DiablosGit/FTCMS/README.md

This is an attempt to build an easy to use BMS on easy to use Hardware. Everyone contributing to this project is welcome.
