DiablosGit/FTCMS/FTCMS_V2.2/Auslegung Komponenten.rtf

Balancer Widerstand:

Maximum Cell Voltage: U_cutoff 4.2 V
Assumed %SoC Inbalance: SoC_disbalance 2.5 %
Module Capacity 5p C_5p 15 Ah
Number of Hours to Balance t_balance 8 h

Balance Current I_b
I_b = SoC_disbalance * C_5p / t_balance = 0.025 * 15 Ah /3h = 125 mA

Balance Resistance R_b = 4,2V / 125mA = 33Ohm

Powerless in heat:
P_v_balance = R_b * I_b² = 33 Ohm * (0.125A)² = 0.5 W

Temperature measurement:

Sensor: Heraeus M222 PT1000
Messtrom 0,1mA-0,3mA
Selbsterwärumung 0,4K/mW bei 0°C

Messtrom mit Spannungsteiler 1k/1k bei 5V : I=5V/2kOhm = 2,5mA -> Leistung: P=RII = 1000*0,0025 = 0W
Wiederstandsberechnungee
R = R0 * (1+ (dT * 3850 *10^-6 )
(R/R0 -1) /3850 *10^-6 = dT
