DiablosGit/FTCMS/FTCMS_V2.2/Bauteileliste FCTMS.xlsx

Kürzel | Wert | Bauteil | Menge vorhanden | Menge benötigt | Link | Stückpreis
U1 |  | ADBMS1818ASWZ | 1 | 4 | https://www.mouser.de/ProductDetail/Analog-Devices/ADBMS1818ASWZ?qs=pUKx8fyJudB64VZO6QRyWQ%3D%3D | 18.37 €
U2 |  | TSX631AILT | 2 | 4 | https://www.mouser.de/ProductDetail/STMicroelectronics/TSX631AILT?qs=761d0DE0fW%252ByRDkJAhndjg%3D%3D | 1.10 €
J1 + J2 |  | Molex 43045-2021 | 2 | 4 | https://www.mouser.de/ProductDetail/Molex/43045-2021?qs=pWIReIhcJCRhcaPh7u89sg%3D%3D | 3.80 €
J3 + J6 |  | Molex 43045-0228 | 5 | 8 | https://www.mouser.de/ProductDetail/Molex/43045-0228?qs=W1HJaynCbQzqlbKVi%252Bs9Mw%3D%3D | 0.82 €
J4 |  | Molex 43045-0400 | 1 | 4 | https://www.mouser.de/ProductDetail/Molex/43045-0400?qs=UeCeOHRHQeaIqmxE9Bxdrw%3D%3D | 1.03 €
TR1 |  | H0068ANL |  | 4 | https://www.mouser.de/ProductDetail/Pulse-Electronics/H0068ANL?qs=fi7yB2oewZmWr2X2uJO3ng%3D%3D | 5.32 €
Q1 |  | DZT5551-13 | 1 | 4 | https://www.mouser.de/ProductDetail/Diodes-Incorporated/DZT5551-13?qs=oDfC%252BbpzniwTf3QVWCXpgQ%3D%3D | 0.50 €
R1 |  | 100R
R0+ R2-R20 |  | CRM1206-FX-10R0ELF | 24 | 19 | https://www.mouser.de/ProductDetail/Bourns/CRM1206-FX-10R0ELF?qs=%2FxfeZyN5VBdEtVlwvTuF%252Bg%3D%3D | 0.11 €
R21 |  | 100R
R22 |  | 220R
R23 |  | 0R
R24 |  | - | - | - | -
R25 |  | 0R
R26-R29 |  | 51R
R30 |  | 1-3K
R31 |  | 100R
R1B1 - R18B1 |  | SG73P2BTTD330J |  |  | https://www.mouser.de/ProductDetail/KOA-Speer/SG73P2BTTD330J?qs=zqP1Ye0pHbjf43wxrOBe9Q%3D%3D | 0.13 €
RT1-RT9 |  | 10k1%
C1-C19 |  | 10u 0603 |  |  | https://www.mouser.de/ProductDetail/KYOCERA-AVX/0603YD106MAT2A | 0.84 €
C20 |  | CC1206KFX7R0BB104 | 36 | 4 | https://www.mouser.de/ProductDetail/YAGEO/CC1206KFX7R0BB104?qs=7s%252B3O6pAiyDaQFObAxTH8w%3D%3D | 0.23 €
C21+C22+C24 |  | CC1206KKX7RCBB103 | 1 | 24 | https://www.mouser.de/ProductDetail/YAGEO/CC1206KKX7RCBB103?qs=TpUtqFO9vU8xNiNH6sQ3Gg%3D%3D | 0.51 €
C23+C25 |  | C1206C105K4RAC | 1 | 8 | https://www.mouser.de/ProductDetail/KEMET/C1206C105K4RAC?qs=esDHISMOsl1e4qSv4fn%2FRQ%3D%3D | 0.14 €
C26 |  | 10n
C27+C29-C31 |  | - | - | - | -
C28 |  | 1u
C32 |  | 100n100v
D1 |  | 1206 LED | 1
