DiablosGit/FTCMS/FTCMS_V2.2/H0068ANL_3D.STEP

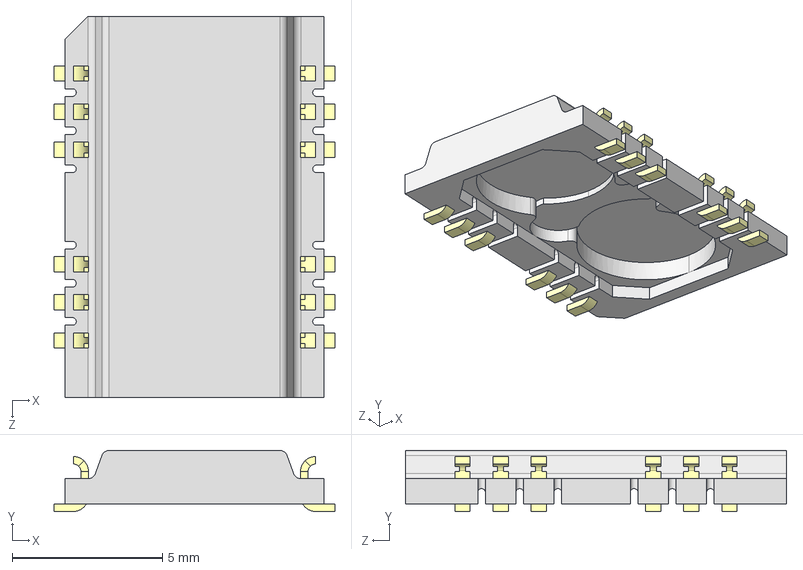
[picture p1: CAD file, 2025-05-25]
FTCMS_V2.2/H0068ANL_3D.STEP
9.36 x 2.03 x 12.7 mm
