DiablosGit/FTCMS/FTCMS_V2.2/FTCMS_V2.2.step

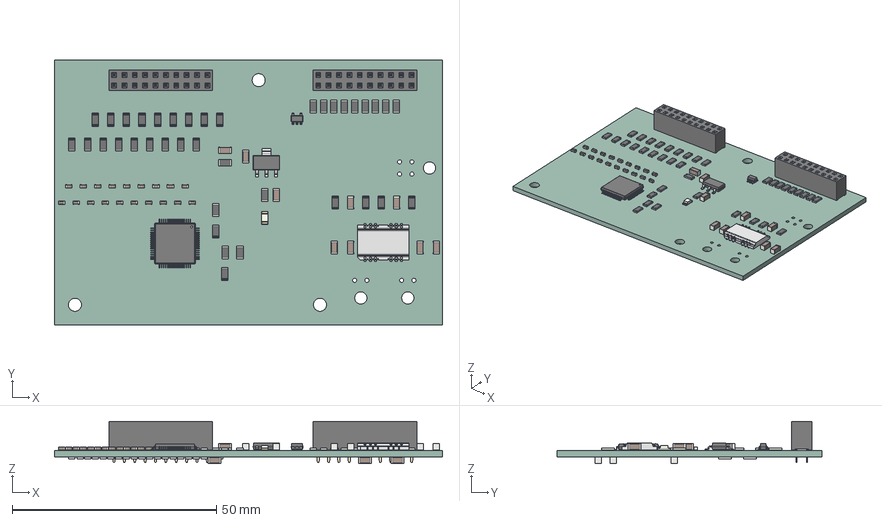
[picture p2: CAD file, 2025-05-25]
FTCMS_V2.2/FTCMS_V2.2.step
95.0 x 65.0 x 10.3 mm
PCB
