DiablosGit/FTCMS/(list of files, cad)

Other CAD files:
FTCMS_V2.2/FTCMS_V2.2/FTCMS_V2.2/FTCMS_V2.2.ipt
