DiablosGit/FTCMS/(threads)

Thread 1 (2024-12-19):

Some questions about creating a BMS with the adbms1818.

maybethomas, 2024-12-19:
Hi,

Just came across your repository while looking for resources on how to use the adbms1818 (there aren't many!). I'm trying to create a BMS as a university project, but the whole wiring up ICs and creating PCBs is new to me. I have made an initial schematic on kicad (with some help from your files.) but still unsure about a few things. Would you mind it if i asked you a few questions? It seems like you've got it figured out. I'm not sure if i should be asking these types of question on here, so don't worry if not.

Thanks!
