DiablosGit/FTCMS/FTCMS_V2.2/FTCMS_V2.2.kicad_pcb

## KiCad design FTCMS_V2.2/FTCMS_V2.2.kicad_pcb (2025-05-25)

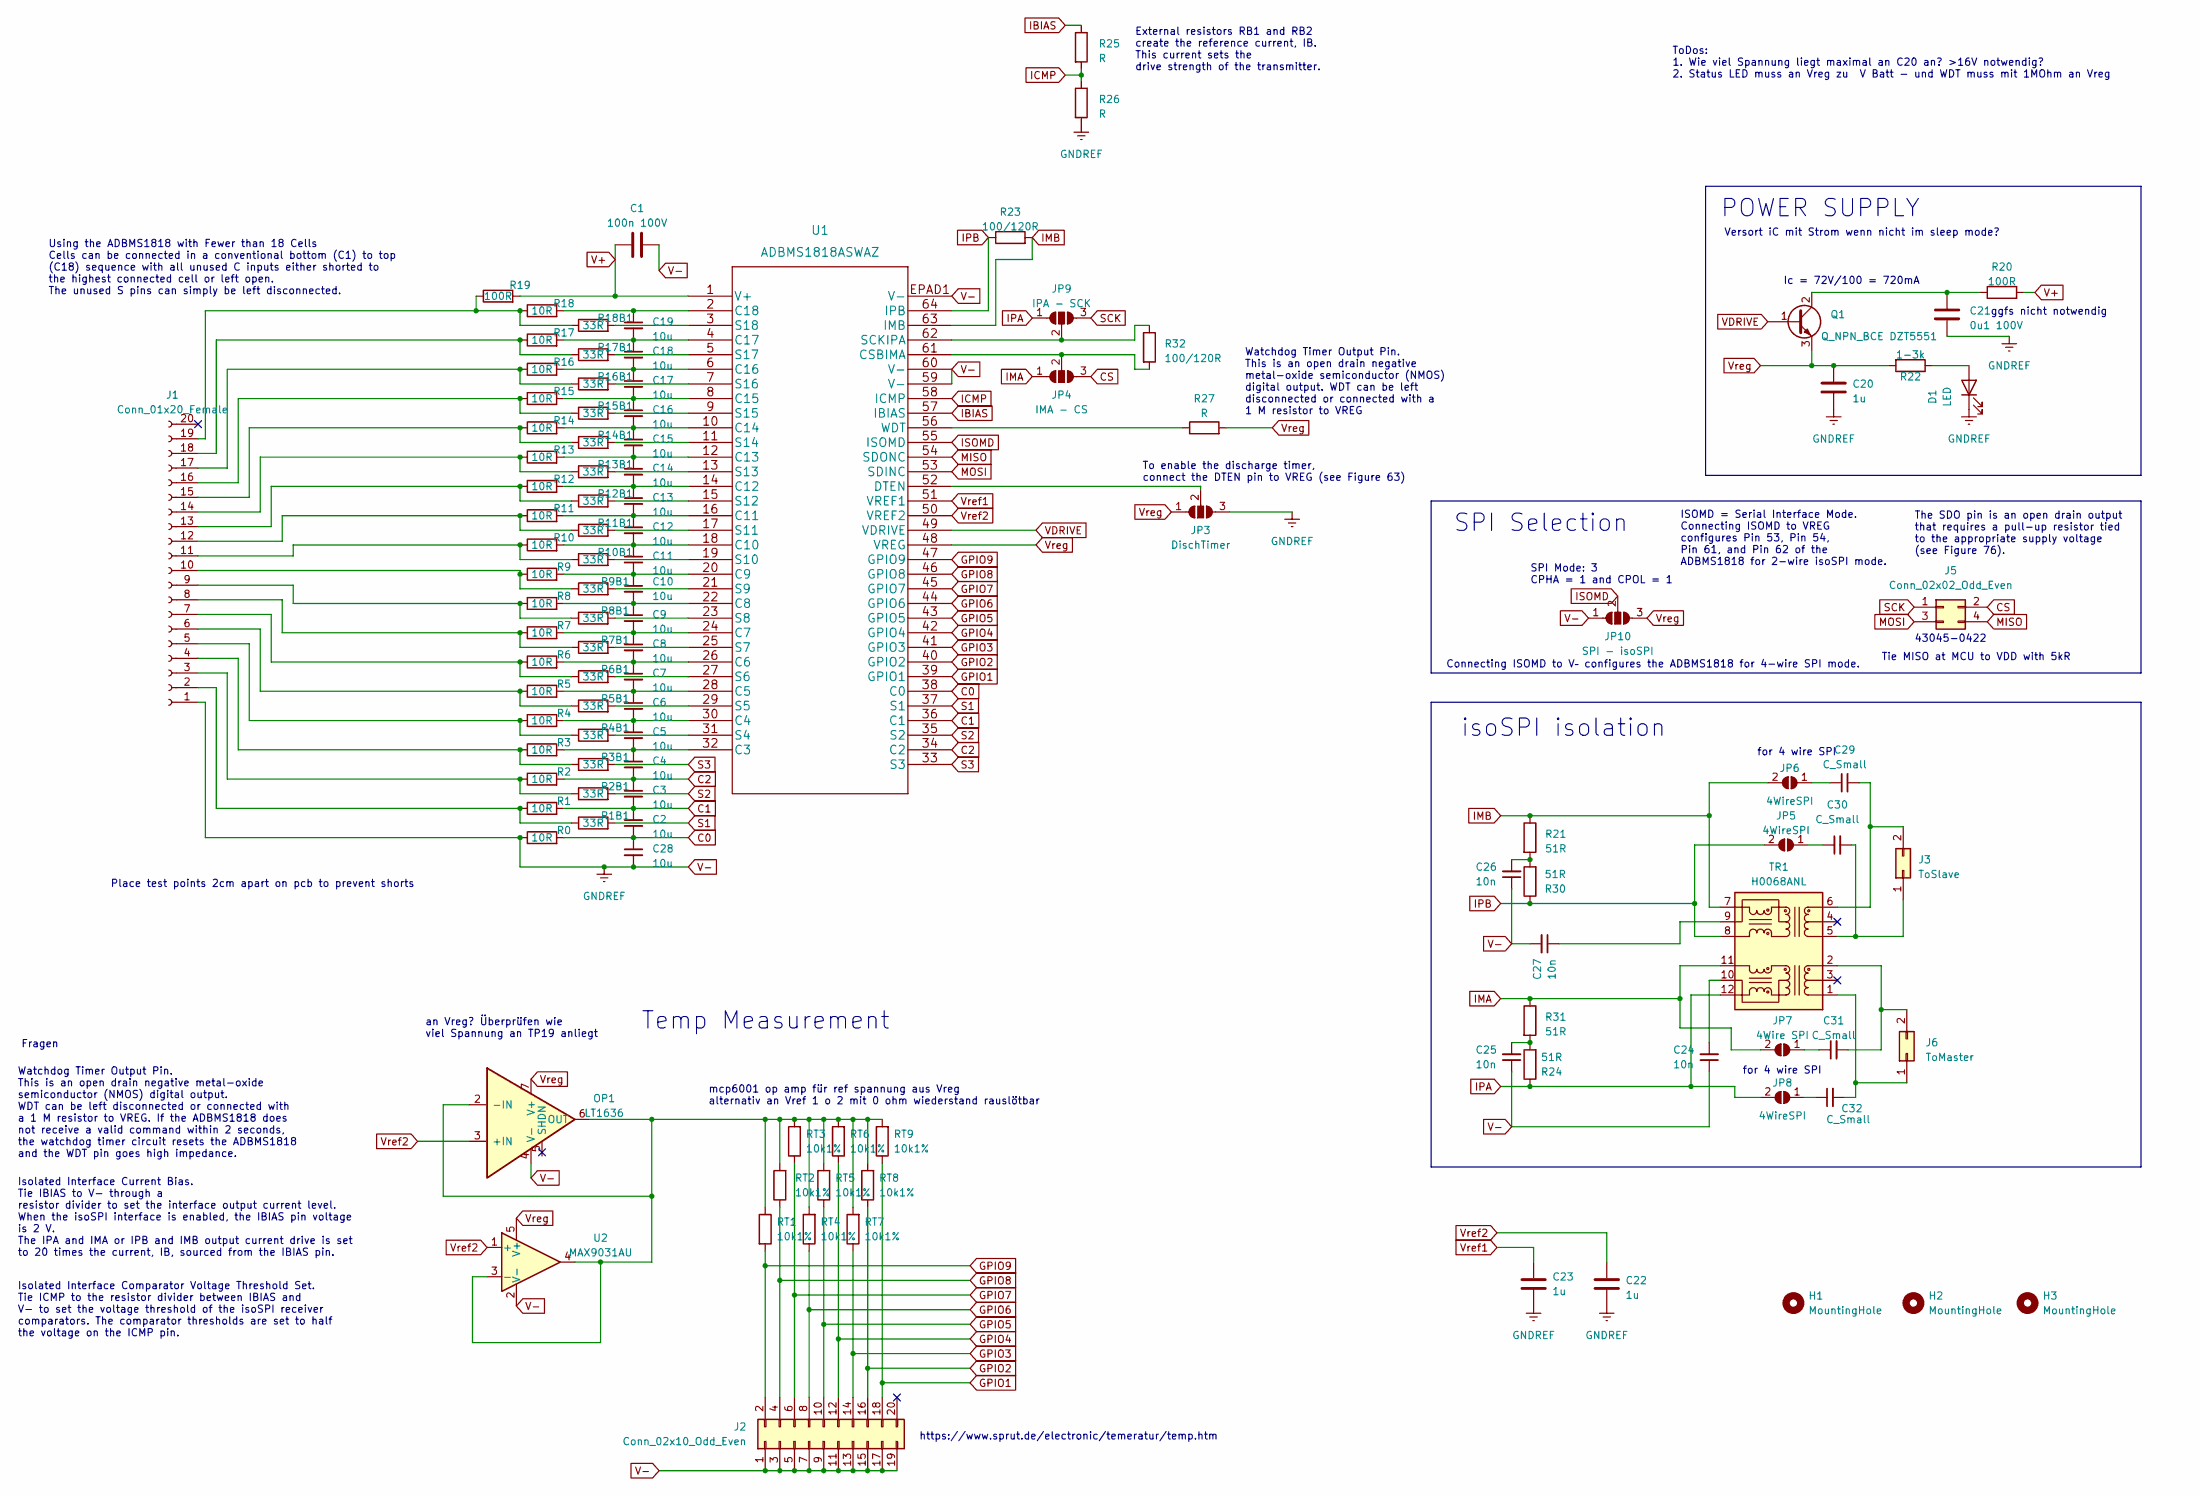
[picture p3: schematic FTCMS_V2.2.kicad_sch]

Parts:
C1: 100n 100V; C_1206_3216Metric_Pad1.33x1.80mm_HandSolder
C2, C3, C4, C5, C6, C7, C8, C9, C10, C11, C12, C13, C14, C15, C16, C17, C18, C19, C28: 10u; C_0603_1608Metric_Pad1.08x0.95mm_HandSolder
C20, C22, C23: 1u; C_1206_3216Metric_Pad1.33x1.80mm_HandSolder
C21: 0u1 100V; C_1206_3216Metric_Pad1.33x1.80mm_HandSolder
C24, C25, C26, C27: 10n; C_1206_3216Metric_Pad1.33x1.80mm_HandSolder
C29, C30, C31, C32: C_Small; C_1206_3216Metric_Pad1.33x1.80mm_HandSolder
D1: LED; LED_1206_3216Metric_Pad1.42x1.75mm_HandSolder
H1, H2, H3: MountingHole; MountingHole_3.2mm_M3_DIN965
J1: Conn_01x20_Female; PinSocket_2x10_P2.54mm_Vertical
J2: Conn_02x10_Odd_Even; PinSocket_2x10_P2.54mm_Vertical
J3: ToSlave; Molex_Micro-Fit_3.0_43650-0200_1x02_P3.00mm_Horizontal
J5: Conn_02x02_Odd_Even; Molex_Micro-Fit_3.0_43045-0400_2x02_P3.00mm_Horizontal
J6: ToMaster; Molex_Micro-Fit_3.0_43650-0200_1x02_P3.00mm_Horizontal
JP3: DischTimer; SolderJumper-3_P2.0mm_Open_TrianglePad1.0x1.5mm
JP4: IMA - CS; SolderJumper-3_P2.0mm_Open_TrianglePad1.0x1.5mm
JP5, JP6, JP8: 4WireSPI; SolderJumper-2_P1.3mm_Open_TrianglePad1.0x1.5mm
JP7: 4Wire SPI; SolderJumper-2_P1.3mm_Open_TrianglePad1.0x1.5mm
JP9: IPA - SCK; SolderJumper-3_P2.0mm_Open_TrianglePad1.0x1.5mm
JP10: SPI - isoSPI; SolderJumper-3_P2.0mm_Open_TrianglePad1.0x1.5mm
OP1: LT1636; DIP-8_W7.62mm_Socket_LongPads
Q1: Q_NPN_BCE DZT5551; SOT-223-3_TabPin2
R0, R1, R2, R3, R4, R5, R6, R7, R8, R9, R10, R11, R12, R13, R14, R15, R16, R17, R18: 10R; R_1206_3216Metric_Pad1.30x1.75mm_HandSolder
R1B1, R2B1, R3B1, R4B1, R5B1, R6B1, R7B1, R8B1, R9B1, R10B1, R11B1, R12B1, R13B1, R14B1, R15B1, R16B1, R17B1, R18B1: 33R; R_1206_3216Metric_Pad1.30x1.75mm_HandSolder
R19, R20: 100R; R_1206_3216Metric_Pad1.30x1.75mm_HandSolder
R21, R24, R30, R31: 51R; R_1206_3216Metric_Pad1.30x1.75mm_HandSolder
R22: 1-3k; R_1206_3216Metric_Pad1.30x1.75mm_HandSolder
R23, R32: 100/120R; R_1206_3216Metric_Pad1.30x1.75mm_HandSolder
R25, R26, R27: R; R_1206_3216Metric_Pad1.30x1.75mm_HandSolder
RT1, RT2, RT3, RT4, RT5, RT6, RT7, RT8, RT9: 10k1%; R_1206_3216Metric_Pad1.30x1.75mm_HandSolder
TR1: H0068ANL
U1: ADBMS1818ASWAZ; LQFP-64-1EP_10x10mm_P0.5mm_EP5x5mm_ThermalVias
U2: MAX9031AU; SOT-23-5

Connections:
C0: C2.2, C28.1, R0.2, U1.38 (C0)
C1: C2.1, C3.2, R1.2, U1.36 (C1)
C2: C3.1, C4.2, R2.2, U1.34 (C2)
CS: J5.2, JP4.3 (B)
GPIO1: J2.18, RT9.1, U1.39 (GPIO1)
GPIO2: J2.16, RT8.1, U1.40 (GPIO2)
GPIO3: J2.14, RT7.1, U1.41 (GPIO3)
GPIO4: J2.12, RT6.1, U1.42 (GPIO4)
GPIO5: J2.10, RT5.1, U1.43 (GPIO5)
GPIO6: J2.8, RT4.1, U1.44 (GPIO6)
GPIO7: J2.6, RT3.1, U1.45 (GPIO7)
GPIO8: J2.4, RT2.1, U1.46 (GPIO8)
GPIO9: J2.2, RT1.2, U1.47 (GPIO9)
IBIAS: R25.1, U1.57 (IBIAS)
ICMP: R25.2, R26.1, U1.58 (ICMP)
IMA: JP4.1 (A), JP7.2 (B), R31.1, TR1.11 (RX-)
IMB: JP6.2 (B), R21.1, R23.2, TR1.7 (TX-), U1.63 (IMB)
IPA: JP8.2 (B), JP9.1 (A), R24.1, TR1.12 (RX+)
IPB: JP5.2 (B), R23.1, R30.1, TR1.8 (TX+), U1.64 (IPB)
ISOMD: JP10.2 (C), U1.55 (ISOMD)
MISO: J5.4, U1.54 (SDONC)
MOSI: J5.3, U1.53 (SDINC)
unnamed: C25.2, R24.2, R31.2
unnamed: C26.2, R21.2, R30.2
unnamed: D1.2 (A), R22.1
unnamed: J1.2, R1.1, R1B1.1
unnamed: J1.3, R2.1, R2B1.1
unnamed: J1.4, R3.1, R3B1.1
unnamed: J1.5, R4.1, R4B1.1
unnamed: J1.6, R5.1, R5B1.1
unnamed: J1.7, R6.1, R6B1.1
unnamed: J1.8, R7.1, R7B1.1
unnamed: J1.9, R8.1, R8B1.1
unnamed: J1.10, R9.1, R9B1.1
unnamed: J1.11, R10.1, R10B1.1
unnamed: J1.12, R11.1, R11B1.1
unnamed: J1.13, R12.1, R12B1.1
unnamed: J1.14, R13.1, R13B1.1
unnamed: J1.15, R14.1, R14B1.1
unnamed: J1.16, R15.1, R15B1.1
unnamed: J1.17, R16.1, R16B1.1
unnamed: J1.18, R17.1, R17B1.1
unnamed: J1.19, R18.1, R18B1.1, R19.1
unnamed: C30.2, J3.1, TR1.5 (TD+)
unnamed: C29.2, J3.2, TR1.6 (TD-)
unnamed: C32.2, J6.1, TR1.1 (RD+)
unnamed: C31.2, J6.2, TR1.2 (RD-)
unnamed: JP3.2 (C), U1.52 (DTEN)
unnamed: JP4.2 (C), R32.2, U1.61 (CSBIMA)
unnamed: C30.1, JP5.1 (A)
unnamed: C29.1, JP6.1 (A)
unnamed: C31.1, JP7.1 (A)
unnamed: C32.1, JP8.1 (A)
unnamed: JP9.2 (C), R32.1, U1.62 (SCKIPA)
unnamed: OP1.2 (-IN), OP1.6 (OUT), RT1.1, RT2.2, RT3.2, RT4.2, RT5.2, RT6.2, RT7.2, RT8.2, RT9.2, U2.3 (-), U2.4
unnamed: C21.1, Q1.2 (C), R20.1
unnamed: C24.2, TR1.10 (RXCT)
unnamed: C27.1, TR1.9 (TXCT)
unnamed: C4.1, C5.2, R3.2, U1.32 (C3)
unnamed: C5.1, C6.2, R4.2, U1.30 (C4)
unnamed: C6.1, C7.2, R5.2, U1.28 (C5)
unnamed: C7.1, C8.2, R6.2, U1.26 (C6)
unnamed: C8.1, C9.2, R7.2, U1.24 (C7)
unnamed: C9.1, C10.2, R8.2, U1.22 (C8)
unnamed: C10.1, C11.2, R9.2, U1.20 (C9)
unnamed: C11.1, C12.2, R10.2, U1.18 (C10)
unnamed: C12.1, C13.2, R11.2, U1.16 (C11)
unnamed: C13.1, C14.2, R12.2, U1.14 (C12)
unnamed: C14.1, C15.2, R13.2, U1.12 (C13)
unnamed: C15.1, C16.2, R14.2, U1.10 (C14)
unnamed: C16.1, C17.2, R15.2, U1.8 (C15)
unnamed: C17.1, C18.2, R16.2, U1.6 (C16)
unnamed: C18.1, C19.2, R17.2, U1.4 (C17)
unnamed: C19.1, R18.2, U1.2 (C18)
unnamed: R4B1.2, U1.31 (S4)
unnamed: R5B1.2, U1.29 (S5)
unnamed: R6B1.2, U1.27 (S6)
unnamed: R7B1.2, U1.25 (S7)
unnamed: R8B1.2, U1.23 (S8)
unnamed: R9B1.2, U1.21 (S9)
unnamed: R10B1.2, U1.19 (S10)
unnamed: R11B1.2, U1.17 (S11)
unnamed: R12B1.2, U1.15 (S12)
unnamed: R13B1.2, U1.13 (S13)
unnamed: R14B1.2, U1.11 (S14)
unnamed: R15B1.2, U1.9 (S15)
unnamed: R16B1.2, U1.7 (S16)
unnamed: R17B1.2, U1.5 (S17)
unnamed: R18B1.2, U1.3 (S18)
unnamed: R27.1, U1.56 (WDT)
S1: R1B1.2, U1.37 (S1)
S2: R2B1.2, U1.35 (S2)
S3: R3B1.2, U1.33 (S3)
SCK: J5.1, JP9.3 (B)
V+: C1.1, R19.2, R20.2, U1.1 (V+)
V-: C1.2, C20.2, C21.2, C22.2, C23.2, C24.1, C25.1, C26.1, C27.2, C28.2, D1.1 (K), J1.1, J2.1, J2.3, J2.5, J2.7, J2.9, J2.11, J2.13, J2.15, J2.17, J2.19, JP3.3 (B), JP10.1 (A), R0.1, R26.2, U1.59 (V-), U1.60 (V-), U1.EPAD1 (V-), U2.2 (V-)
VDRIVE: Q1.1 (B), U1.49 (VDRIVE)
Vref1: C23.1, U1.51 (VREF1)
Vref2: C22.1, U1.50 (VREF2), U2.1 (+)
Vreg: C20.1, JP3.1 (A), JP10.3 (B), Q1.3 (E), R22.2, R27.2, U1.48 (VREG), U2.5 (V+)

Notes on the sheet:
ToDos: 1. Wie viel Spannung liegt maximal an C20 an? >16V notwendig? 2. Status LED muss an Vreg zu V Batt - und WDT muss mit 1MOhm an Vreg
https://www.sprut.de/electronic/temeratur/temp.htm
Watchdog Timer Output Pin. This is an open drain negative metal-oxide semiconductor (NMOS) digital output. WDT can be left disconnected or connected with a 1 M resistor to VREG. If the ADBMS1818 does not receive a valid command within 2 seconds, the watchdog timer circuit resets the ADBMS1818 and t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
Watchdog Timer Output Pin. This is an open drain negative metal-oxide semiconductor (NMOS) digital output. WDT can be left disconnected or connected with a 1 M resistor to VREG
SPI Selection
Place test points 2cm apart on pcb to prevent shorts
POWER SUPPLY
To enable the discharge timer, connect the DTEN pin to VREG (see Figure 63)
Temp Measurement
SPI Mode: 3 CPHA = 1 and CPOL = 1
Isolated Interface Current Bias. Tie IBIAS to V- through a resistor divider to set the interface output current level. When the isoSPI interface is enabled, the IBIAS pin voltage is 2 V. The IPA and IMA or IPB and IMB output current drive is set to 20 times the current, IB, sourced from the IBIAS p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
Ic = 72V/100 = 720mA
for 4 wire SPI
isoSPI isolation
an Vreg? Überprüfen wie viel Spannung an TP19 anliegt
43045-0422
mcp6001 op amp für ref spannung aus Vreg alternativ an Vref 1 o 2 mit 0 ohm wiederstand rauslötbar
External resistors RB1 and RB2 create the reference current, IB. This current sets the drive strength of the transmitter.
Using the ADBMS1818 with Fewer than 18 Cells Cells can be connected in a conventional bottom (C1) to top (C18) sequence with all unused C inputs either shorted to the highest connected cell or left open. The unused S pins can simply be left disconnected.
Tie MISO at MCU to VDD with 5kR
ggfs nicht notwendig
Versort iC mit Strom wenn nicht im sleep mode?
Isolated Interface Comparator Voltage Threshold Set. Tie ICMP to the resistor divider between IBIAS and V- to set the voltage threshold of the isoSPI receiver comparators. The comparator thresholds are set to half the voltage on the ICMP pin.
ISOMD = Serial Interface Mode. Connecting ISOMD to VREG configures Pin 53, Pin 54, Pin 61, and Pin 62 of the ADBMS1818 for 2-wire isoSPI mode.
Connecting ISOMD to V– configures the ADBMS1818 for 4-wire SPI mode.
Fragen
The SDO pin is an open drain output that requires a pull-up resistor tied to the appropriate supply voltage (see Figure 76).

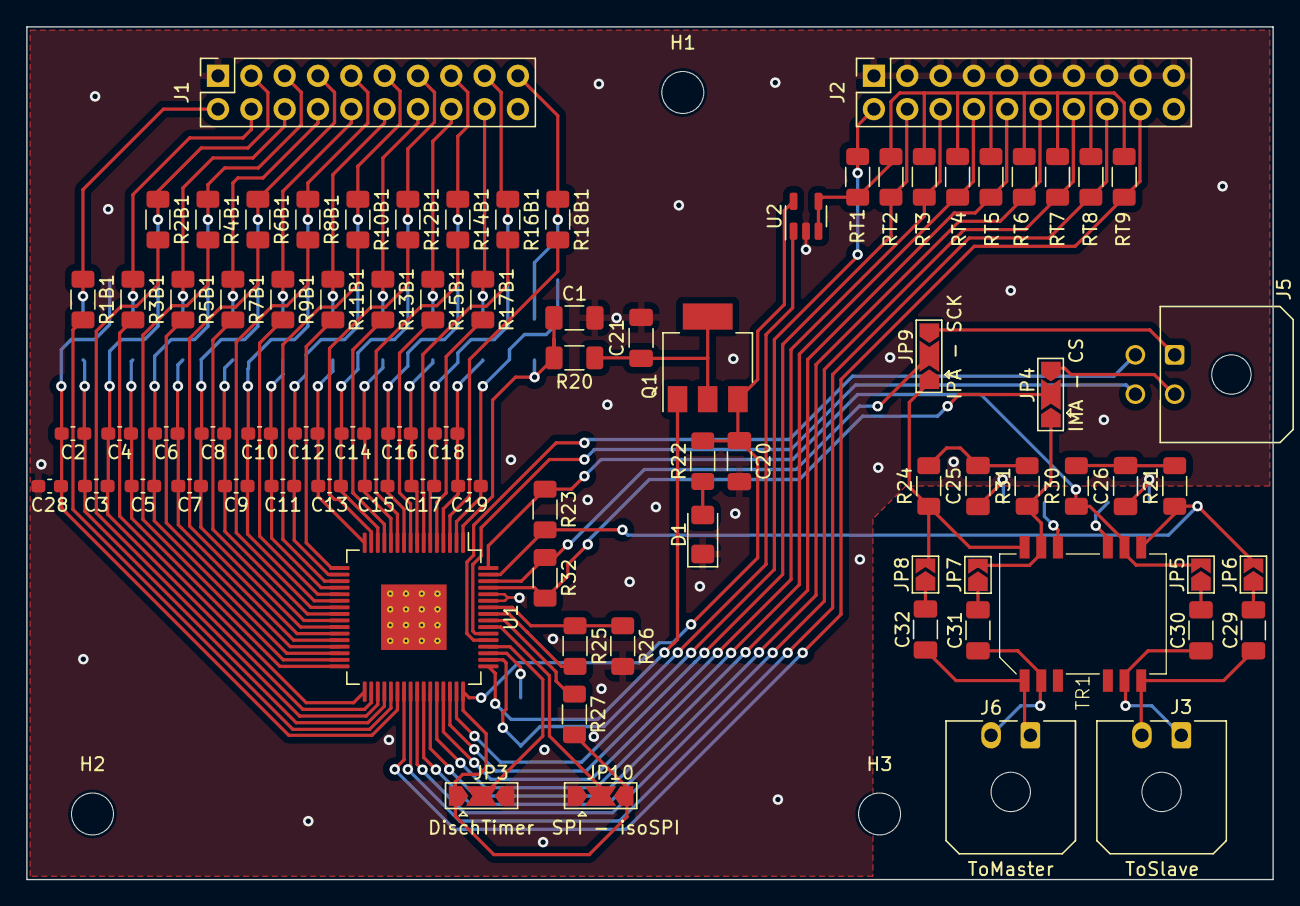
[picture p4: board FTCMS_V2.2.kicad_pcb from above]

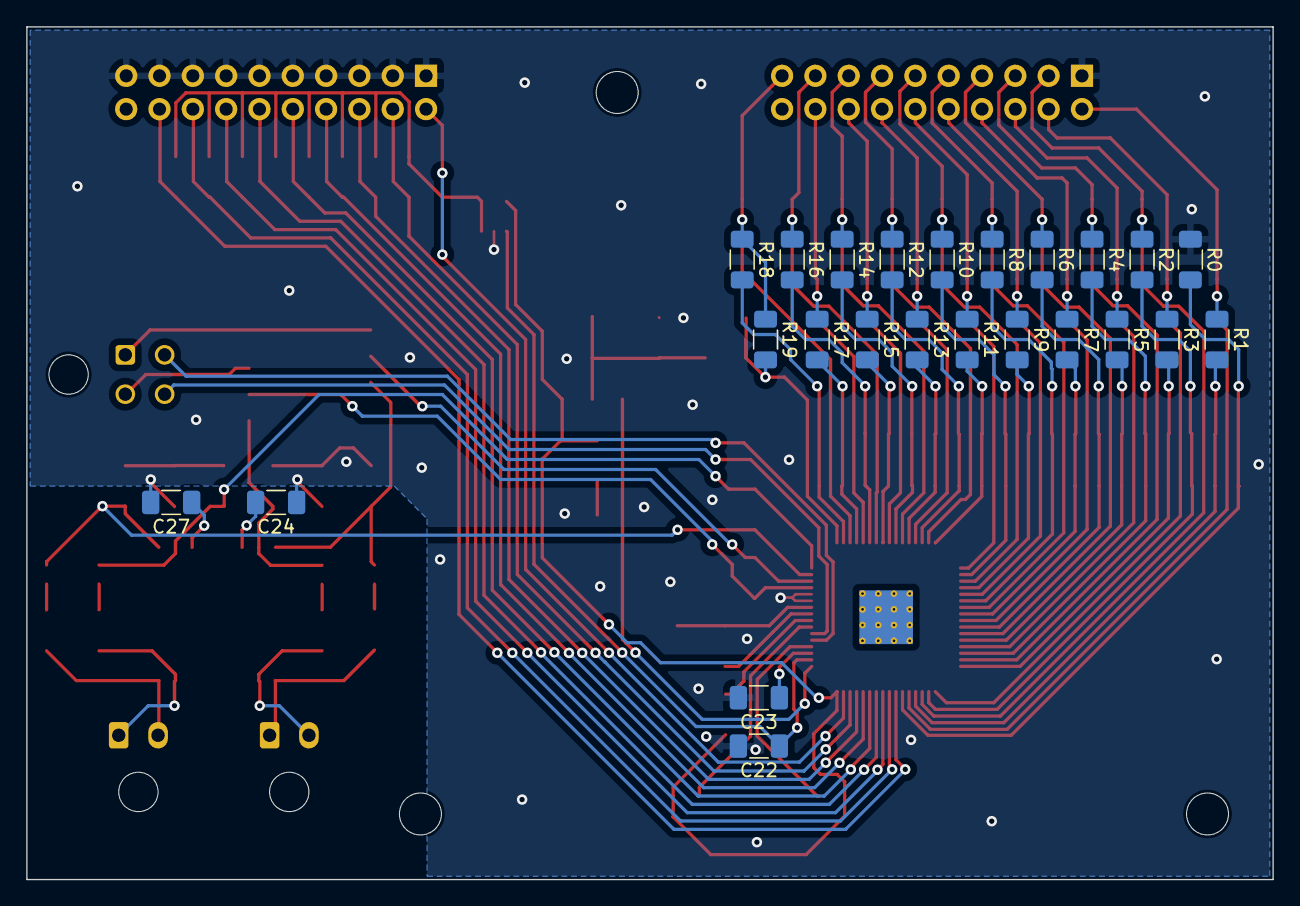
[picture p5: board FTCMS_V2.2.kicad_pcb from below]

Board: 2 copper layers, 95.0 x 65.0 mm, 111 parts (24 on the bottom side), 100 nets.
