DiablosGit/FTCMS/SW/FTCMS/include/bms_hardware.h

/*!
  ADBMS181x hardware library
@verbatim
  This library contains all of the hardware dependant functions used by the bms
  code
@endverbatim

Copyright 2018(c) Analog Devices, Inc.

All rights reserved.

Redistribution and use in source and binary forms, with or without
modification, are permitted provided that the following conditions are met:
 - Redistributions of source code must retain the above copyright
   notice, this list of conditions and the following disclaimer.
 - Redistributions in binary form must reproduce the above copyright
   notice, this list of conditions and the following disclaimer in
   the documentation and/or other materials provided with the
   distribution.
 - Neither the name of Analog Devices, Inc. nor the names of its
   contributors may be used to endorse or promote products derived
   from this software without specific prior written permission.
 - The use of this software may or may not infringe the patent rights
   of one or more patent holders.  This license does not release you
   from the requirement that you obtain separate licenses from these
   patent holders to use this software.
 - Use of the software either in source or binary form, must be run
   on or directly connected to an Analog Devices Inc. component.

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
Copyright 2017 Linear Technology Corp. (LTC)
*/
#ifndef BMSHARDWARE_H
#define BMSHARDWARE_H


// included in Arduino?!
#include <stdint.h>


void cs_low(uint8_t pin);//name conflicts with linduino

void cs_high(uint8_t pin);

void delay_u(uint16_t micro);

void delay_m(uint16_t milli);

void set_spi_freq();


/*
Writes an array of bytes out of the SPI port
*/
void spi_write_array(uint8_t len, // Option: Number of bytes to be written on the SPI port
                     uint8_t data[] //Array of bytes to be written on the SPI port
                    );
/*
 Writes and read a set number of bytes using the SPI port.

*/

void spi_write_read(uint8_t tx_Data[],//array of data to be written on SPI port
                    uint8_t tx_len, //length of the tx data arry
                    uint8_t *rx_data,//Input: array that will store the data read by the SPI port
                    uint8_t rx_len //Option: number of bytes to be read from the SPI port
                   );

uint8_t spi_read_byte(uint8_t tx_dat);//name conflicts with linduino also needs to take a byte as a parameter
#endif
