DiablosGit/FTCMS/FTCMS_V2.2/Datasheets/LTSketchbook/Part Number/6000/6952/DC2609A/DC2609A.ino

/*!
DC2609A
LTC6952: Ultralow Jitter, 4.5GHz PLL with 11 Outputs and JESD204B Support

@verbatim

  Setup:
    Set the terminal baud rate to 115200 and select the newline terminator.
    Refer to Demo Manual DC2609A.
    One Power Supply is needed for this demo board: 3.3V supply.


Command Description:
    1-  Load Default Settings from a Look-up Table- Loads the SPI map from one of several options in a
        look-up table.  The look-up table allows the user to select different frequencies and synchronization
        option.

    2-  READ/WRITE to Registers Addresses- Selecting this option will cause all the registers to
        be read, stored to variables, and displayed.  The user will then have the option
        to write to one register address at a time.

    3-  READ/WRITE to Registers Fields- Selecting this option will allow the user
        to read or write to one register field name at a time.

    4-  This function stores the current SPI settings in the demo boards EEPROM

    5-  This function loads SPI settings from the demo boards EEPROM to the device

    6 - SPI Frequency:  Allows user to control Linduino's SPI frequency.  By default this is set to 8MHz
        when connecting Linduino directly to the DC2609.  If Linduino is connected to the DC2430 the default
        SPI rate is 4MHz

    7 - If using a DC2430 (Linduino Expander), this allows the user to select 1 of 8 sites to talk to.

USER INPUT DATA FORMAT:
 decimal : 1024
 hex     : 0x400
 octal   : 02000  (leading 0 "zero")
 binary  : B10000000000
 float   : 1024.0

@endverbatim

http://www.linear.com/product/LTC6952

http://www.linear.com/product/LTC6952#demoboards


Copyright 2018(c) Analog Devices, Inc.

All rights reserved.

Redistribution and use in source and binary forms, with or without
modification, are permitted provided that the following conditions are met:
 - Redistributions of source code must retain the above copyright
   notice, this list of conditions and the following disclaimer.
 - Redistributions in binary form must reproduce the above copyright
   notice, this list of conditions and the following disclaimer in
   the documentation and/or other materials provided with the
   distribution.
 - Neither the name of Analog Devices, Inc. nor the names of its
   contributors may be used to endorse or promote products derived
   from this software without specific prior written permission.
 - The use of this software may or may not infringe the patent rights
   of one or more patent holders.  This license does not release you
   from the requirement that you obtain separate licenses from these
   patent holders to use this software.
 - Use of the software either in source or binary form, must be run
   on or directly connected to an Analog Devices Inc. component.

THIS SOFTWARE IS PROVIDED BY ANALOG DEVICES "AS IS" AND ANY EXPRESS OR
IMPLIED WARRANTIES, INCLUDING, BUT NOT LIMITED TO, NON-INFRINGEMENT,
MERCHANTABILITY AND FITNESS FOR A PARTICULAR PURPOSE ARE DISCLAIMED.
IN NO EVENT SHALL ANALOG DEVICES BE LIABLE FOR ANY DIRECT, INDIRECT,
INCIDENTAL, SPECIAL, EXEMPLARY, OR CONSEQUENTIAL DAMAGES (INCLUDING, BUT NOT
LIMITED TO, INTELLECTUAL PROPERTY RIGHTS, PROCUREMENT OF SUBSTITUTE GOODS OR
SERVICES; LOSS OF USE, DATA, OR PROFITS; OR BUSINESS INTERRUPTION) HOWEVER
CAUSED AND ON ANY THEORY OF LIABILITY, WHETHER IN CONTRACT, STRICT LIABILITY,
OR TORT (INCLUDING NEGLIGENCE OR OTHERWISE) ARISING IN ANY WAY OUT OF THE USE
OF THIS SOFTWARE, EVEN IF ADVISED OF THE POSSIBILITY OF SUCH DAMAGE.
*/

/*! @file
    @ingroup LTC6952
*/

#include <Arduino.h>
#include <stdint.h>
#include "Linduino.h"
#include "LT_SPI.h"
#include "UserInterface.h"
#include "LT_I2C.h"
#include "QuikEval_EEPROM.h"
#include "LTC6952.h"
#include <SPI.h>
#include <Wire.h>

// Function Declaration
void print_title();             // Print the title block
void print_prompt();            // Print the main menu
void menu_1_load_default_settings();  // Sub-menus
void menu_2_RW_to_reg_addresss();
void menu_3_RW_to_reg_field();
void menu_4_store_settings();
void menu_5_restore_settings();
void menu_6_SPI_speed();
void menu_7_DC2430_site_select();
//void DUTsync();

// Global Variables
static int8_t demo_board_connected = 0;    //!< Demo Board Name stored in QuikEval EEPROM
static int8_t DC2609_board_connected = 0;  //!< Demo Board Name stored in QuikEval EEPROM
uint8_t First_Run=0;                       //!< if first time through loop = 0, otherwise=1
boolean Using_DC2430= false;               //!< Indicator if DC2430 (Linduino Expander) is connected

// Analog Pins used on DC2430 (Linduino Expander)
int dc2430_site_A0_APin =0;                //!< DC2430 resistor tree, if it reads 3.3V then DC2430 connected
int dc2430_site_A1_APin =1;                //!< DC2430 resistor tree, if it reads 1.66V then DC2430 connected
int dc2430_site_A2_APin =2;                //!< DC2430 INFO ONLY, measures DC2226 (Linduino) VCCIO voltage

// Digital Pins used on DC2430 (Linduino Expander)
int dc2430_site_DA0_Pin =2;                //!< DC2430 digital pin allows Linduino to control which DC2430 site is selected
int dc2430_site_DA1_Pin =3;                //!< DC2430 digital pin allows Linduino to control which DC2430 site is selected
int dc2430_site_DA2_Pin =4;                //!< DC2430 digital pin allows Linduino to control which DC2430 site is selected
int dc2430_en_Pin =5;                      //!< DC2430 digital pin enables Linduino to control which DC2430 site is selected & turns on DC2430 LED

/* ------------------------------------------------------------------------- */
//! Initialize Linduino
//! @return void
void setup()
{
  char demo_name[] = "DC2609";    // Demo Board Name stored in QuikEval EEPROM
  uint8_t data;
  int site_select=0;
  int dc2430_A0_val=0;
  int dc2430_A1_val=0;
  int dc2430_A2_val=0;
  float dc2430_A0_fval=0;
  float dc2430_A1_fval=0;
  float dc2430_A2_fval=0;

  Serial.println(F("--- start ---"));

  Using_DC2430= false;

  quikeval_SPI_init();      //! Configure the spi port for 500kHz SCK
  quikeval_SPI_connect();   //! Connect SPI to main data port
  quikeval_I2C_init();      //! Configure the EEPROM I2C port for 100kHz
  Serial.begin(115200);     //! Initialize the serial port to the PC
  LTC6952_init();
  print_title();

//! **************** DETECT IF USING DC2430 SECTION ******************
//! this checks to see if a DC2026 (linduino) to DC2430 (linduino expander)
//! by measuring 3 analog voltages
//! if a DC2430 is connect then read A0, A1 , A2
  dc2430_A0_val = analogRead(dc2430_site_A0_APin);
  dc2430_A0_fval = (5.0*dc2430_A0_val)/1023;

  dc2430_A1_val = analogRead(dc2430_site_A1_APin);
  dc2430_A1_fval = (5.0*dc2430_A1_val)/1023;


//! If DC2430 located, auto search site 0 to 7 until a DC2609 is found
  if ((dc2430_A0_fval>3.0) && (dc2430_A0_fval<3.6) && (dc2430_A1_fval>1.5) && (dc2430_A1_fval<1.8))
  {
    Serial.println(F("--- DC2430 Connected ---"));
    Using_DC2430= true;
    pinMode(dc2430_site_DA0_Pin, OUTPUT);
    pinMode(dc2430_site_DA1_Pin, OUTPUT);
    pinMode(dc2430_site_DA2_Pin, OUTPUT);
    pinMode(dc2430_en_Pin, OUTPUT);      // sets the digital pin as output
    DC2609_board_connected =0;
    demo_board_connected = 0;

    digitalWrite(dc2430_en_Pin, HIGH);   // sets the LED on
    site_select=0;
    do
    {
      dc2430_site_select(site_select);
      delay(150);  //! probably could be shorter, but this allows the eyes to track which site is being tested
      demo_board_connected = discover_demo_board_local(demo_name);  //! Checks if any demo board is connected.
      if (demo_board_connected)
      {
        Serial.println(F("\n********************************************************"));
        DC2609_board_connected = discover_demo_board(demo_name);  //! Checks if correct demo board is connected.

        if (DC2609_board_connected)
        {
          dc2430_A2_val = analogRead(dc2430_site_A2_APin);
          dc2430_A2_fval = (5.0*dc2430_A2_val)/1023;
          Serial.print(F("Linduino's JP3 VCCIO voltage = "));
          Serial.println(dc2430_A2_fval);     //! if DC2430 connect, VCCIO voltage set by JP3 on DC2026
          spi_enable(SPI_CLOCK_DIV4);  //! 1) Configure the spi port for 4MHz SCK
          Serial.println(F("Linduino's SPI Frequency = 4MHz, max DC2430 SPI speed"));
          Serial.print(F("\nDC2609 FOUND ON DC2430 SITE "));
          Serial.println(site_select);
          site_select=15;
        }
      }

      if (!DC2609_board_connected)
      {
        Serial.print(F("\nDC2609 NOT FOUND ON DC2430 SITE "));
        Serial.print(site_select);
        site_select++;
      }
    }
    while (site_select<8);

    //! if no DC2609A was found.  Return dc2430_en_Pin to default state (LOW)
    if (!DC2609_board_connected)
    {
      digitalWrite(dc2430_en_Pin, LOW);   // sets the LED on
      Serial.println(F("\n\nConnect DC2609 demo board to DC2430, then press the reset button."));
    }
  }
  else
  {
    //! If DC2430 is not located, check to see if Linduino is connected directly to the DC2609
    //! most common use case
    Serial.println(F("DC2609A CONNECTED TO LINDUINO"));
    DC2609_board_connected = discover_demo_board(demo_name);  //! Checks if correct demo board is connected.
    if (DC2609_board_connected)
    {
      Serial.println(F("Linduino's SPI Frequency = 8MHz, max speed"));
      spi_enable(SPI_CLOCK_DIV2);  //! 1) Configure the spi port for 8MHz SCK
    }
  }

  if (DC2609_board_connected)
  {
    print_prompt();
  }
} // end of setup()


/* ------------------------------------------------------------------------- */
//! Repeats Linduino loop
//! @return void
void loop()
{
  uint16_t user_command;          // User input command

  if (Serial.available())          // Check for user input
  {
    if (First_Run==0)
    {
      First_Run=1;
    }

    user_command = read_int();  //! Reads the user command
    if (user_command != 'm')
      Serial.println(user_command);

    switch (user_command)       //! Prints the appropriate submenu
    {
      case 1:
        menu_1_load_default_settings();
        break;

      case 2:
        menu_2_RW_to_reg_addresss();
        break;

      case 3:
        menu_3_RW_to_reg_field();
        break;

      case 4:
        menu_4_store_settings();
        break;

      case 5:
        menu_5_restore_settings();
        break;

      case 6:
        menu_6_SPI_speed();
        break;

      case 7:
        menu_7_DC2430_site_select();
        break;


      default:
        Serial.println(F("Incorrect Option"));
        break;
    } // end of switch statement
    Serial.println(F("\n*****************************************************************"));
    print_prompt();
  } // end of if statement
} // end of loop()

// Function Definitions
/* ------------------------------------------------------------------------- */
//! Menu 1: Load Default SPI Register Settings
//!  This function loads the register settings from a look up table.
//!  The settings in the look up table were created using the LTC6952Wizard.
//!  It is recommended to use the LTC6952Wizard to create the register settings for
//!  all desired frequency plans and enter these frequency plans into a look-up table.
//!  The LTC6952Wizard generates register values for optimal LTC6952 performance.
//! @return void
void menu_1_load_default_settings()
{

  uint8_t  field_num;
  long field_val;

  field_val=999L;
  field_num=1;
// Read/Write loop, can exit loop by choosing 'm'
  while  (field_num != 0)
  {
    Serial.print(F("\n*****************************************************************"));
    Serial.print(F("\n*************    Select LTC6952 Configuration   *****************"));
    Serial.println(F("\n*****************************************************************"));

    // Select Fields to read and write to
    Serial.print(F("1-  LTC6952 Front Page Datasheet Application\n"));
    Serial.print(F("2-  LTC6952 All output div 1\n"));
    Serial.println(F("0 - Return to Main Menu\n"));

    Serial.println(F("Load LTC6952 register settings from a look up table (Settings created from LTC6952Wizard)"));
    Serial.println(F("Enter a command (1-2), or '0' to return to Main Menu): "));
    field_num = read_int();  //! Reads the user command
    Serial.println(field_num);

    // User input: enter new setting for selected register
    if (field_num != 0)
    {
      field_num=field_num-1;
      set_LTC6952_REGS_lkup_tbl(field_num);
      field_num=field_num+1;
    } // end if user_command != 0 statement
  } // end while loop
} // end menu_1_load_default_settings function


/* ------------------------------------------------------------------------- */
//! Menu 2: Reads and/or Writes the SPI register address
//!  This function reads and displays all SPI register address settings in HEX format.
//!  It then provides an option to modify(write to) individual registers one at time
//!
//!  EXAMPLE:
//!  - 0- ADDR00 = 0x29 (read only)
//!  - 1- ADDR01 = 0xAA
//!  - ....
//!  - 54- ADDR36 = 0x00     55- ADDR37 = 0x00
//!  - 56- ADDR38 = 0x13 (read only)
//!  - 0 - Return to Main Menu
//!  - Enter a command (1-55 to modify register, or '0' to return to Main Menu):
//! @return void
void menu_2_RW_to_reg_addresss()
{
  uint8_t i, regval, user_regval, num_reg;
  uint16_t user_address;          // User input command

  num_reg = get_LTC6952_REGSIZE();
  user_address=1;
// Read/Write loop, can exit loop by choosing '0'
  while  (user_address != 0)
  {
    Serial.println(F("\n*****************************************************************"));
    // Read All Registers and display results
    for (i=0; i<num_reg; i++)
    {
      regval = LTC6952_read(LTC6952_CS,i);
      Serial.print(i);
      if (i<16)
        Serial.print(F("- ADDR0"));
      else
        Serial.print(F("- ADDR"));
      Serial.print(i, HEX);
      Serial.print(F(" = 0x"));
      if (regval<16) Serial.print(F("0"));
      Serial.print(regval, HEX);
      if (i==2) Serial.print(F(" (warning: if D0=1 it resets all registers. POR Bit)"));
      if ((i==0)||(i==(num_reg-1))) Serial.print(F(" (read only) "));
      if (i<4||(i==(num_reg-1))) Serial.println("");
      else if ((i%2) == 1) Serial.println("");
      else Serial.print("     ");
    }  // end for loop
    Serial.print(F("0 - Return to Main Menu\n\n"));
    // User input: Select which register to modify, or return to main menu
    Serial.print(F("Enter a command (1-55 to modify register, or '0' to return to Main Menu): "));
    user_address = read_int();  //! Reads the user command
    Serial.println(user_address);

    // User input: enter new setting for selected register
    if (user_address >0 && user_address<(num_reg-1))
    {
      Serial.print(F("What value should ADDR"));
      Serial.print(user_address);
      Serial.print(F(" be set to (ex: HEX format 0xff): "));
      user_regval = read_int();  //! Reads the user command
      Serial.println(user_regval);

      // writes new setting to part
      LTC6952_write(LTC6952_CS, (uint8_t)user_address, user_regval);
    } // end if statement
  } // end while loop
}  // end menu_2_RW_to_reg_addresss


/* ------------------------------------------------------------------------- */
//! Support function for function menu_3_RW_to_reg_field
//!  displays current state of select field
//!  provides user the option to write to that field or return to menu
//!  @return field value (user input) that will be written to part
long field_menu_RW(long field_val,       //!< current state of the selected field
                   char field_name[],    //!< SPI Field name selected
                   uint8_t f            //!< SPI field identifier identifies selected fields information in SPI MAP arrays
                  )
{
  long usr_field_val;
  uint8_t field_size, i;
  long max_num=1, pow2=1;

  Serial.print("CURRENT STATE (HEX): 0x");
  Serial.println(field_val, HEX);

  if (get_LTC6952_SPI_FIELD_RW(f)==0)
  {
    field_size=get_LTC6952_SPI_FIELD_NUMBITS(f);
    for (i=1; i<field_size; i++)
    {
      pow2=pow2*2;
      max_num=max_num + pow2;
    }

    Serial.print("Set Value or type '-1' to exit: (ex: HEX format 0x00 to 0x");
    Serial.print(max_num, HEX);
    Serial.print(")");
    usr_field_val = read_int();  //! Reads the user command

    if (usr_field_val>=0 && usr_field_val<=max_num)
    {
      Serial.println(usr_field_val);
      return usr_field_val;
    }
    else
    {
      return field_val;
    } // end of if statement
  } // end of if statement
} // end of field_menu_RW


/* ------------------------------------------------------------------------- */
//! Menu 3: Reads and/or Writes individual SPI fields
//!  This function provides the user with a list of all SPI fields.
//!  The user can select a SPI field to read its current value.
//!  Then the user will be provided with an option to write to that field
//!  or return to the selection menu.
//!
//!  EXAMPLE:
//!  - 1-ADEL0   43-MD4     85-PART
//!  - 2-ADEL1   44-MD5     86-PDALL
//!  - ....
//!  - 40-MD1     82-OINV9   124-VCOOK
//!  - 41-MD2     83-OINV10  125-x
//!  - 42-MD3     84-PARSYNC
//!  - 0 - Return to Main Menu
//!  - * = READ ONLY FIELD
//!  - Enter a command (1-125 to modify register, or '0' to return to Main Menu)
//! @return void
void menu_3_RW_to_reg_field()
{
  uint8_t  field_num;
  long field_val;

  field_val=999L;
  field_num=1;
// Read/Write loop, can exit loop by choosing 'm'
  while  (field_num != 0)
  {
    Serial.println(F("\n*****************************************************************"));
    // Select Fields to read and write to
    Serial.print(F("  1-ADEL0   43-MD4     85-PART\n"));
    Serial.print(F("  2-ADEL1   44-MD5     86-PDALL\n"));
    Serial.print(F("  3-ADEL2   45-MD6     87-PDPLL\n"));
    Serial.print(F("  4-ADEL3   46-MD7     88-PDREFPK\n"));
    Serial.print(F("  5-ADEL4   47-MD8     89-PDVCOPK\n"));
    Serial.print(F("  6-ADEL5   48-MD9     90-PD10\n"));
    Serial.print(F("  7-ADEL6   49-MD10    91-PD9\n"));
    Serial.print(F("  8-ADEL7   50-MODE0   92-PD8\n"));
    Serial.print(F("  9-ADEL8   51-MODE1   93-PD7\n"));
    Serial.print(F(" 10-ADEL9   52-MODE2   94-PD6\n"));
    Serial.print(F(" 11-ADEL10  53-MODE3   95-PD5\n"));
    Serial.print(F(" 12-BST     54-MODE4   96-PD4\n"));
    Serial.print(F(" 13-CP      55-MODE5   97-PD3\n"));
    Serial.print(F(" 14-CPDN    56-MODE6   98-PD2\n"));
    Serial.print(F(" 15-CPINV   57-MODE7   99-PD1\n"));
    Serial.print(F(" 16-CPMID   58-MODE8   100-PD0\n"));
    Serial.print(F(" 17-CPRST   59-MODE9   101-POR\n"));
    Serial.print(F(" 18-CPUP    60-MODE10  102-RAO\n"));
    Serial.print(F(" 19-CPWIDE  61-MP0     103-RD\n"));
    Serial.print(F(" 20-DDEL0   62-MP1     104-nREFOK\n"));
    Serial.print(F(" 21-DDEL1   63-MP2     105-REFOK\n"));
    Serial.print(F(" 22-DDEL2   64-MP3     106-REV\n"));
    Serial.print(F(" 23-DDEL3   65-MP4     107-SYSCT\n"));
    Serial.print(F(" 24-DDEL4   66-MP5     108-SRQMD\n"));
    Serial.print(F(" 25-DDEL5   67-MP6     109-SSRQ\n"));
    Serial.print(F(" 26-DDEL6   68-MP7     110-SRQEN0\n"));
    Serial.print(F(" 27-DDEL7   69-MP8     111-SRQEN1\n"));
    Serial.print(F(" 28-DDEL8   70-MP9     112-SRQEN2\n"));
    Serial.print(F(" 29-DDEL9   71-MP10    113-SRQEN3\n"));
    Serial.print(F(" 30-DDEL10  72-ND      114-SRQEN4\n"));
    Serial.print(F(" 31-EZMD    73-OINV0   115-SRQEN5\n"));
    Serial.print(F(" 32-FILTR   74-OINV1   116-SRQEN6\n"));
    Serial.print(F(" 33-FILTV   75-OINV2   117-SRQEN7\n"));
    Serial.print(F(" 34-INVSTAT 76-OINV3   118-SRQEN8\n"));
    Serial.print(F(" 35-LKCT    77-OINV4   119-SRQEN9\n"));
    Serial.print(F(" 36-LKWIN   78-OINV5   120-SRQEN10\n"));
    Serial.print(F(" 37-nLOCK   79-OINV6   121-TEMPO\n"));
    Serial.print(F(" 38-LOCK    80-OINV7   122-UNLOCK\n"));
    Serial.print(F(" 39-MD0     81-OINV8   123-nVCOOK\n"));
    Serial.print(F(" 40-MD1     82-OINV9   124-VCOOK\n"));
    Serial.print(F(" 41-MD2     83-OINV10  125-x\n"));
    Serial.print(F(" 42-MD3     84-PARSYNC\n"));

    Serial.print(F("0 - Return to Main Menu\n"));
    Serial.print(F("* = READ ONLY FIELD\n\n"));

    Serial.print(F("Enter a command (1-125 to modify register, or '0' to return to Main Menu): "));
    field_num = read_int();  //! Reads the user command
    Serial.println(field_num);

    // User input: enter new setting for selected register
    if (field_num != 0)
    {
      switch (field_num)        //! Prints the appropriate submenu
      {
        default:
          field_val=get_LTC6952_SPI_FIELD(LTC6952_CS,field_num);    // reads selected field
          field_val=field_menu_RW(field_val," ",field_num);      // user interface control and printout
          if (field_val>-1)
          {
            set_LTC6952_SPI_FIELD(LTC6952_CS, field_num, field_val); // updates selected field
          }
          break;
      }  // end of switch statement
    } // end if user_command != 0 statement
  } // end while loop
}  // end menu_3_RW_to_reg_field function


/* ------------------------------------------------------------------------- */
//! Store PLL settings to nonvolatile EEPROM on demo board
//! @return void
void menu_4_store_settings()
{
// Store the PLL Settings to the EEPROM
  uint8_t regval;

  uint8_t addr_offset;
  uint8_t num_reg;

  addr_offset=2;
  num_reg = get_LTC6952_REGSIZE();

  eeprom_write_int16(EEPROM_I2C_ADDRESS, EEPROM_CAL_KEY, EEPROM_CAL_STATUS_ADDRESS);         // Cal key

  for (uint8_t i = 0; i <= num_reg ; i++)
  {
    regval = LTC6952_read(LTC6952_CS,i);
    eeprom_write_byte(EEPROM_I2C_ADDRESS,(char) regval, EEPROM_CAL_STATUS_ADDRESS+ i+addr_offset);
  }
  Serial.println(F("PLL Settings Stored to EEPROM"));

}

/* ------------------------------------------------------------------------- */
//! Read stored PLL settings from nonvolatile EEPROM on demo board
//! @return void
void menu_5_restore_settings()
{
// Read the PLL settings from EEPROM
  int16_t cal_key;
  uint8_t regval;
  uint8_t user_address;

  uint8_t addr_offset;
  uint8_t num_reg;
  long field_val;
  uint8_t  field_num;

  addr_offset=2;
  num_reg = get_LTC6952_REGSIZE();

// read the cal key from the EEPROM
  eeprom_read_int16(EEPROM_I2C_ADDRESS, &cal_key, EEPROM_CAL_STATUS_ADDRESS);
  if (cal_key == EEPROM_CAL_KEY)
  {
    // PLL Settings has been stored, read PLL Settings
    user_address=2;
    for (uint8_t i = 0; i <= num_reg ; i++)
    {
      eeprom_read_byte(EEPROM_I2C_ADDRESS,(char *) &regval, EEPROM_CAL_STATUS_ADDRESS + i+addr_offset);
      LTC6952_write(LTC6952_CS, (uint8_t)i, regval);
      user_address++;
    }
    Serial.println(F("LTC6952 Settings Restored"));

    Serial.println(F("Syncs LTC6952 OUTPUTS"));
    DUTsync(1);

  }
  else
  {
    Serial.println(F("PLL Settings not found"));
  }

}

/* ------------------------------------------------------------------------- */
//! Syncs LTC6952 Outputs using SSYNC bit
//! @return void
void DUTsync(uint16_t delay_num)
{
  set_LTC6952_SPI_FIELD(LTC6952_CS, LTC6952_SSRQ, 1L);
  delay(1);
  set_LTC6952_SPI_FIELD(LTC6952_CS, LTC6952_SSRQ, 0L);
  delay(delay_num);
}



/* ------------------------------------------------------------------------- */
//! Read stored PLL settings from nonvolatile EEPROM on demo board
//! @return void
void menu_6_SPI_speed()
{
  int temp_val;

  Serial.println(F("\nCommand Summary:"));
  if (Using_DC2430)
  {
    Serial.println(F("  1-8MHz NOT Available with DC2430"));
  }
  else
  {
    Serial.println(F("  1-SPI Clock = 8MHz"));
  }
  Serial.println(F("  2-SPI Clock = 4MHz"));
  Serial.println(F("  3-SPI Clock = 2MHz"));
  Serial.println(F("  4-SPI Clock = 1MHz"));
  Serial.println(F("  5-SPI Clock = 500kHz"));
  Serial.println("");
  Serial.print(F("Enter a command: "));
  temp_val = read_int();  //! Reads the user command

  switch (temp_val)        //! Prints the appropriate submenu
  {
    case 1:
      if (Using_DC2430)
      {
        Serial.println(F("incorrect option"));
      }
      else
      {
        spi_enable(SPI_CLOCK_DIV2);  //! 1) Configure the spi port for 8MHz SCK
      }
      break;

    case 2:
      spi_enable(SPI_CLOCK_DIV4);  //! 1) Configure the spi port for 4MHz SCK
      break;

    case 3:
      spi_enable(SPI_CLOCK_DIV8);  //! 1) Configure the spi port for 2MHz SCK
      break;

    case 4:
      spi_enable(SPI_CLOCK_DIV16);  //! 1) Configure the spi port for 1MHz SCK
      break;

    case 5:
      spi_enable(SPI_CLOCK_DIV32);  //! 1) Configure the spi port for 500kHz SCK
      break;

    default:
      Serial.println(F("Incorrect Option"));
      break;
  }
}


/* ------------------------------------------------------------------------- */
//! Read stored PLL settings from nonvolatile EEPROM on demo board
//! @return void
void menu_7_DC2430_site_select()
{
  int temp_val;

  Serial.println(F("\nCommand Summary:"));
  Serial.println(F("  0-Site 0"));
  Serial.println(F("  1-Site 1"));
  Serial.println(F("  2-Site 2"));
  Serial.println(F("  3-Site 3"));
  Serial.println(F("  4-Site 4"));
  Serial.println(F("  5-Site 5"));
  Serial.println(F("  6-Site 6"));
  Serial.println(F("  7-Site 7"));

  Serial.println("");
  Serial.print(F("Enter a command: "));
  temp_val = read_int();  //! Reads the user command

  dc2430_site_select(temp_val);
}

/* ------------------------------------------------------------------------- */
//! Called from function menu_8_DC2430_site_select(), programs DC2430 to site selected
//! @return void
void dc2430_site_select(int site_select)
{
  switch (site_select)        //! Prints the appropriate submenu
  {
    case 0:
      digitalWrite(dc2430_site_DA0_Pin, LOW);
      digitalWrite(dc2430_site_DA1_Pin, LOW);
      digitalWrite(dc2430_site_DA2_Pin, LOW);
      break;

    case 1:
      digitalWrite(dc2430_site_DA0_Pin, HIGH);
      digitalWrite(dc2430_site_DA1_Pin, LOW);
      digitalWrite(dc2430_site_DA2_Pin, LOW);
      break;

    case 2:
      digitalWrite(dc2430_site_DA0_Pin, LOW);
      digitalWrite(dc2430_site_DA1_Pin, HIGH);
      digitalWrite(dc2430_site_DA2_Pin, LOW);
      break;

    case 3:
      digitalWrite(dc2430_site_DA0_Pin, HIGH);
      digitalWrite(dc2430_site_DA1_Pin, HIGH);
      digitalWrite(dc2430_site_DA2_Pin, LOW);
      break;

    case 4:
      digitalWrite(dc2430_site_DA0_Pin, LOW);
      digitalWrite(dc2430_site_DA1_Pin, LOW);
      digitalWrite(dc2430_site_DA2_Pin, HIGH);
      break;

    case 5:
      digitalWrite(dc2430_site_DA0_Pin, HIGH);
      digitalWrite(dc2430_site_DA1_Pin, LOW);
      digitalWrite(dc2430_site_DA2_Pin, HIGH);
      break;

    case 6:
      digitalWrite(dc2430_site_DA0_Pin, LOW);
      digitalWrite(dc2430_site_DA1_Pin, HIGH);
      digitalWrite(dc2430_site_DA2_Pin, HIGH);
      break;

    case 7:
      digitalWrite(dc2430_site_DA0_Pin, HIGH);
      digitalWrite(dc2430_site_DA1_Pin, HIGH);
      digitalWrite(dc2430_site_DA2_Pin, HIGH);
      break;

    default:
      Serial.println(F("Incorrect Option"));
      break;
  }
}

/* ------------------------------------------------------------------------- */
//!    Prints the title block when program first starts.
void print_title()
{

  Serial.println(F("\n*****************************************************************"));
  Serial.println(F("* DC2609 Demonstration Program                                  *"));
  Serial.println(F("*   - Input Voltage 4-6V (J32)                                  *"));
  Serial.println(F("*   - Input Voltage 9-12V (J30)                                  *"));
  Serial.println(F("*                                                               *"));
  Serial.println(F("* This program demonstrates how to send data to the LTC6952     *"));
  Serial.println(F("*  Ultralow Jitter, 4.5GHz PLL with 11 Outputs and JESD204B     *"));
  Serial.println(F("*   Support.                                                    *"));
  Serial.println(F("*                                                               *"));
  Serial.println(F("* Set the baud rate to 115200 and select the newline terminator.*"));
  Serial.println(F("*                                                               *"));
  Serial.println(F("* Recommendations on how to best use LTC6952Wizard and DC2609   *"));
  Serial.println(F("* Linduino code together                                        *"));
  Serial.println(F("* Use LTC6952Wizard to                                          *"));
  Serial.println(F("*  - determine best SPI register values for specific            *"));
  Serial.println(F("*    frequenices and Sync Methods for all settings              *"));
  Serial.println(F("*  - Simulate LTC6952 Phase noise and Time Domain response      *"));
  Serial.println(F("*  - initial engineering evaluation                             *"));
  Serial.println(F("* use DC2609 Linduino code                                      *"));
  Serial.println(F("*  - Create a look up table of the SPI register values created  *"));
  Serial.println(F("*    from LTC6952Wizard (option 1)                              *"));
  Serial.println(F("*  - Software development for reading and writing to specific   *"));
  Serial.println(F("*    register/address (option 2 & 3)                            *"));
  Serial.println(F("*  - Storing demo board settings on the demo board EEPROM       *"));
  Serial.println(F("*  - starting place to use the DC2609 with the DC2430           *"));
  Serial.println(F("*****************************************************************"));
  Serial.println();
} // end of print_title


/* ------------------------------------------------------------------------- */
//!    Prints main menu.
void print_prompt()
{

  Serial.println(F("\nCommand Summary:"));
  Serial.println(F("  1-Load Default Settings from a Look-up Table"));
  Serial.println(F("  2-READ/WRITE to Registers Addresses"));
  Serial.println(F("  3-READ/WRITE to Registers Fields"));
  Serial.println(F("  4-Store LTC6952 SPI settings to the DC2609's EEPROM"));
  Serial.println(F("  5-Restore LTC6952 SPI settings from the DC2609's EEPROM"));
  Serial.println(F("  6-Adjust SPI frequency"));
  if (Using_DC2430)
  {
    Serial.println(F("  7-DC2430 Site Selector"));
  }
  Serial.println("");
  Serial.print(F("Enter a command: "));
} // end of print_prompt
