DiablosGit/FTCMS/FTCMS_V2.2/Datasheets/LTSketchbook/Part Number/6000/6603/DC1304A_B/DC1304A_B.ino

/*!
Linear Technology DC1304A-B Demonstration Board.
LTC6603: Dual Matched, High Frequency Bandpass/Lowpass Filters

@verbatim
NOTES
  Setup:
    Set the terminal baud rate to 115200 and select the newline terminator.
    Equipment required is a precision voltage source and a precision
    voltmeter. No external power supply is required. Ensure all jumpers on
    the demo board are installed in their default positions from the
    factory.

USER INPUT DATA FORMAT:
 decimal : 1024
 hex     : 0x400
 octal   : 02000  (leading 0 "zero")
 binary  : B10000000000
 float   : 1024.0

@endverbatim

http://www.analog.com/en/products/amplifiers/adc-drivers/fully-differential-amplifiers/ltc6603.html

http://www.analog.com/en/design-center/evaluation-hardware-and-software/evaluation-boards-kits/dc1304a-b.html



Copyright 2018(c) Analog Devices, Inc.

All rights reserved.

Redistribution and use in source and binary forms, with or without
modification, are permitted provided that the following conditions are met:
 - Redistributions of source code must retain the above copyright
   notice, this list of conditions and the following disclaimer.
 - Redistributions in binary form must reproduce the above copyright
   notice, this list of conditions and the following disclaimer in
   the documentation and/or other materials provided with the
   distribution.
 - Neither the name of Analog Devices, Inc. nor the names of its
   contributors may be used to endorse or promote products derived
   from this software without specific prior written permission.
 - The use of this software may or may not infringe the patent rights
   of one or more patent holders.  This license does not release you
   from the requirement that you obtain separate licenses from these
   patent holders to use this software.
 - Use of the software either in source or binary form, must be run
   on or directly connected to an Analog Devices Inc. component.

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
The views and conclusions contained in the software and documentation are those
of the authors and should not be interpreted as representing official policies,
either expressed or implied, of Linear Technology Corp.

The Linear Technology Linduino is not affiliated with the official Arduino team.
However, the Linduino is only possible because of the Arduino team's commitment
to the open-source community.  Please, visit http://www.arduino.cc and
http://store.arduino.cc , and consider a purchase that will help fund their
ongoing work.
 */

/*! @file
    @ingroup LTC6603
*/

#include <Arduino.h>
#include <stdint.h>
#include "Linduino.h"
#include "LT_SPI.h"
#include "LT_I2C.h"
#include "UserInterface.h"
#include "QuikEval_EEPROM.h"
#include "LTC6603.h"
#include <SPI.h>
#include <Wire.h>

// Function Declaration
void print_title();                         // Print the title block
void print_prompt();                        // Prompt the user for an input command
void print_user_command(uint8_t menu);      // Display selected differential channels
void menu_1_filter_settings();              // Sets the gain and cutoff frequencies
void menu_2_set_gpo();                      // Sets the GPO
void menu_3_shutdown();                     // Shuts down the LTC6603
void menu_4_poweron();                      // Power up the LTC6603

// Global variables
uint8_t spi_out;
uint8_t control_byte;
uint8_t filter_gain_settings = LTC6603_GAIN_0dB;
uint8_t filter_lp_settings = LTC6603_LPF0 ;
uint8_t filter_noFunc_settings = LTC6603_NOFUNC0 ;
uint8_t gpio_settings = LTC6603_GPO_LOW ;
uint8_t shdn_settings = LTC6603_SHDN;
float freq_settings = LTC6603_FREQ_MIN; 

//! Initialize Linduino
void setup()
{
  quikeval_SPI_init();  // Configure the spi port for 4MHz SCK
  Serial.begin(115200); // Initialize the serial port to the PC
  print_title();        // Displays the title
  print_prompt();       // Display user options
  control_byte = 0x00;  // A global variable that contains the whole control byte.

}

//! Repeats Linduino loop
void loop()
{
  int16_t user_command;         // The user input command
  if (Serial.available())       // Check for user input
  {
    user_command = read_int();        // Read the user command
    if (user_command != 'm')
      Serial.println(user_command);   // Prints the user command to com port

    switch (user_command)
    {
      case 1:
        menu_1_filter_settings();
        break;
      case 2:
        menu_2_set_gpo();
        break;
      case 3:
        menu_3_shutdown();
        break;
      case 4:
        menu_4_poweron();
        break;
      default:
        Serial.println("Incorrect Option");
        break;
    }
    print_prompt();
  }
}

// Function Definitions

//! Set filter settings
//! @return void
void  menu_1_filter_settings()
{
  int16_t user_command; // The user input command
  while (1)
  {
    Serial.print(F("*************************\n\n"));
    Serial.println (F("0-Enter External Frequency"));
    Serial.println (F("1-Set Gain"));
    Serial.println (F("2-Set Lowpass"));
    Serial.println (F("3-Set No Function Code"));
    Serial.println (F("4-Upload Filter Settings"));
    Serial.print   (F("m-Main Menu\n"));
    Serial.print   (F("\nEnter a Command: "));
    user_command = read_int();                              // Read the single command
    if (user_command == 'm')
      return;
    else
      Serial.println(user_command);
    Serial.println();

    switch (user_command)
    {
      case 0:
        Serial.println (F("Enter Frequency(MHz) between 12MHz-80MHZ"));
        user_command = read_float();
         if (user_command <= LTC6603_FREQ_MAX && user_command >= LTC6603_FREQ_MIN)
             freq_settings = user_command;
         else
             Serial.println (F("incorrect option"));
        break; 
      case 1:
        Serial.println (F("Gain: 0-0dB, 1-6dB, 2-12dB, 3-24dB"));
        user_command = read_int();
        switch (user_command)
        {
          case 0:
            control_byte = (control_byte & LTC6603_GAIN_MASK) | LTC6603_GAIN_0dB;
            break;
          case 1:
            control_byte = (control_byte & LTC6603_GAIN_MASK) | LTC6603_GAIN_6dB;
            break;
          case 2:
            control_byte = (control_byte & LTC6603_GAIN_MASK) | LTC6603_GAIN_12dB;
            break;
          case 3:
            control_byte = (control_byte & LTC6603_GAIN_MASK) | LTC6603_GAIN_24dB;
            break;
          default:
            Serial.println (F("incorrect option"));
        }
        break;
      case 2:
        Serial.println (F("Lowpass Divider:   0-32        1-32        2-128       3-512"));
        calculate_FreqLow(freq_settings);
        user_command = read_int();
        switch (user_command)
        {
          case 0:
            control_byte = (control_byte & LTC6603_LPF_MASK) | LTC6603_LPF3;
            break;
          case 1:
            control_byte = (control_byte & LTC6603_LPF_MASK) | LTC6603_LPF2;
            break;
          case 2:
            control_byte = (control_byte & LTC6603_LPF_MASK) | LTC6603_LPF1;
            break;
          case 3:
            control_byte = (control_byte & LTC6603_LPF_MASK) | LTC6603_LPF0;
            break;
          default:
            Serial.println (F("incorrect option"));
        }
        break;
      case 3:
        Serial.println (F("No Function Hex Code: 0-0x04, 1-0x08, 2-0x00, 3-0x0C"));
        user_command = read_int();
        switch (user_command)
        {
          case 0:
            control_byte = (control_byte & LTC6603_NOFUNC_MASK) | LTC6603_NOFUNC2;
            break;
          case 1:
            control_byte = (control_byte & LTC6603_NOFUNC_MASK) | LTC6603_NOFUNC1;
            break;
          case 2:
            control_byte = (control_byte & LTC6603_NOFUNC_MASK) | LTC6603_NOFUNC0;
            break;
          case 3:
            control_byte = (control_byte & LTC6603_NOFUNC_MASK) | LTC6603_NOFUNC3;
            break;
          default:
            Serial.println (F("incorrect option"));
        }
        break;
      case 4:
        spi_out = control_byte;
        LTC6603_write(LTC6603_CS, &spi_out, (uint8_t)1);
        break;
      default:
        Serial.println("Incorrect Option");
        break;
    }
    Serial.print ("\Control byte 0x" + String(control_byte, HEX) + "\n");
  }
}

void menu_2_set_gpo()
{
  int16_t user_command; // The user input command

  while (1)
  {
    Serial.print(F("*************************\n\n"));
    Serial.println(F("0-Set GPIO Low"));
    Serial.println (F("1-Set GPIO High"));
    Serial.print(F("m-Main Menu\n"));
    Serial.print(F("\nEnter a Command: "));
    user_command = read_int();                              // Read the single command
    if (user_command == 'm')
      return;
    else
      Serial.println(user_command);
    Serial.println();
    switch (user_command)
    {
      case 0:
        control_byte = (control_byte & LTC6603_GPO_MASK) | LTC6603_GPO_LOW;
        spi_out = control_byte;
        LTC6603_write(LTC6603_CS, &spi_out, (uint8_t)1);
        break;
      case 1:
        control_byte = (control_byte & LTC6603_GPO_MASK) | LTC6603_GPO_HIGH;
        spi_out = control_byte;
        LTC6603_write(LTC6603_CS, &spi_out, (uint8_t)1);
        break;
      default:
        Serial.println (F("incorrect option"));
        break;
    }
    Serial.print ("\Control byte 0x" + String(control_byte, HEX) + "\n");
  }
}

void menu_3_shutdown()
{
  Serial.print(F("* The LTC6603 is powered down *\n"));
  control_byte = (control_byte & LTC6603_ONOFF_MASK) | LTC6603_SHDN;
  spi_out = control_byte;
  LTC6603_write(LTC6603_CS, &spi_out, (uint8_t)1);
  Serial.print ("\Control byte 0x" + String(control_byte, HEX) + "\n");

}

void menu_4_poweron()
{
  Serial.print(F("* The LTC6603 is turning on *\n"));
  control_byte = (control_byte & LTC6603_ONOFF_MASK) | LTC6603_PRUP;
  spi_out = control_byte;
  LTC6603_write(LTC6603_CS, &spi_out, (uint8_t)1);
  Serial.print ("\Control byte 0x" + String(control_byte, HEX) + "\n");

}


//! Prints the title block when program first starts.
void print_title()
{
  (F("\n*****************************************************************\n"));
  Serial.print(F("* DC1304A-B Demonstration Program                               *\n"));
  Serial.print(F("*                                                               *\n"));
  Serial.print(F("* This program demonstrates how to send data to the LTC6603.    *\n"));
  Serial.print(F("*                                                               *\n"));
  Serial.print(F("* Set the baud rate to 115200 and select the newline terminator.*\n"));
  Serial.print(F("*                                                               *\n"));
  Serial.print(F("*****************************************************************\n"));
}

//! Prints main menu.
void print_prompt()
{
  Serial.print(F("\n1-Filter Setting\n"));
  Serial.print(F("2-Set General Purpose Output\n"));
  Serial.print(F("3-Power Down LTC6603\n"));
  Serial.print(F("4-Power Up LTC6603\n"));
  Serial.print(F("5-Change the LTC6903 clock frequency\n"));  
  Serial.println();
  Serial.print(F("Enter a command:"));
}

void calculate_FreqLow(float freq)
{
  float div0 = freq/32;
  float div1 = freq/32;
  float div2 = freq/128;
  float div3 = freq/512;
  
  Serial.println ("Lowpass Frequency: 0-" + String(div0,3) + "MHz  1-" + String(div1,3) + "MHz  2-" + String(div2,3) + "MHz  3-"+String(div3,3) + "MHz");
  
  
}
