DiablosGit/FTCMS/(commit log)

2024-10-03 works, currently working on translating the shit..
2025-02-13 seems to work, no more pec error. Used 10k pullup between miso and vdd 5V arduino
    [FTCMS_V2.kicad_pcb, FTCMS_V2.kicad_sch]
2025-02-13 added voltage read and sum of voltage read
2025-05-23 platine debug 1
    [Bauteileliste FCTMS.xlsx, FTCMS_V2.2.ipt, FTCMS_V2.2.kicad_pcb, FTCMS_V2.2.kicad_sch, FTCMS_V2.2.step]
2025-05-25 FCTMS rebuild
    [FTCMS_V2.2.kicad_pcb, FTCMS_V2.2.kicad_sch, FTCMS_V2.2.step, H0068ANL_3D.STEP]
2025-05-25 3d modelle der molex-stecker hinzugefügt
    [FTCMS_V2.2.kicad_pcb, FTCMS_V2.2.kicad_sch]
